skancharla33/Siri_BlueStamp_Portfolio/Bezel+v1.stl

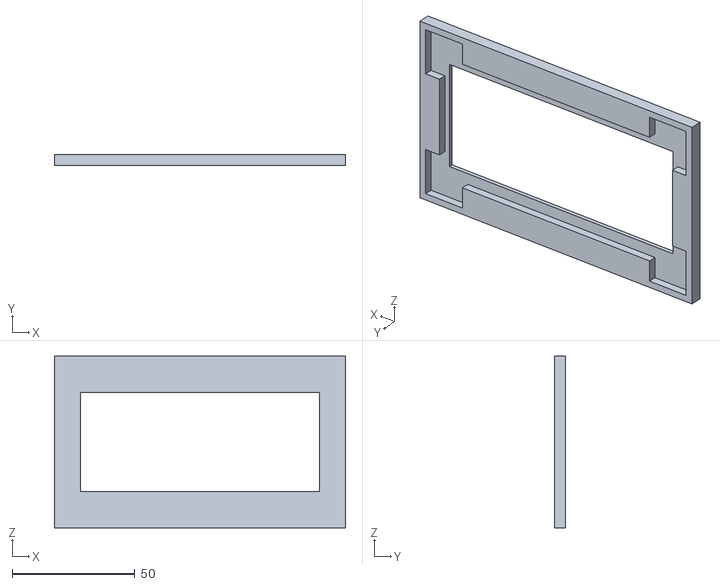
[picture p3: CAD file, 2023-07-21]
Bezel+v1.stl
118.5 x 4.50 x 70.0
