skancharla33/Siri_BlueStamp_Portfolio/(list of files, cad)

Other CAD files:
EnclosureV1+-+Instructables.dxf
