skancharla33/Siri_BlueStamp_Portfolio/(commit log)

2023-06-15 Update index.md
    added item to bill of materials
2023-07-17 Update index.md
    bill of materials
2023-07-18 Update index.md
    finished bill of materials
